upanie/sd-mux/doc/hardware/SDWire/SDWire.kicad_pcb

## KiCad design doc/hardware/SDWire/SDWire.kicad_pcb (2021-04-30)

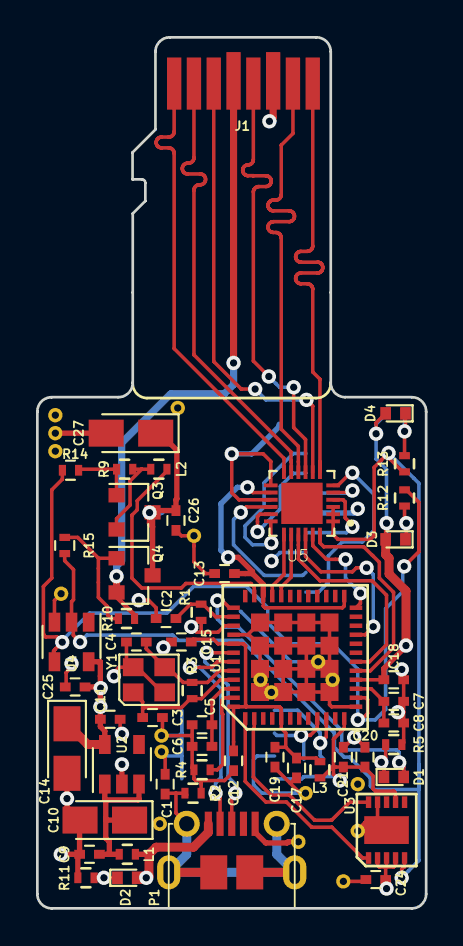
[picture p1: board SDWire.kicad_pcb from above]

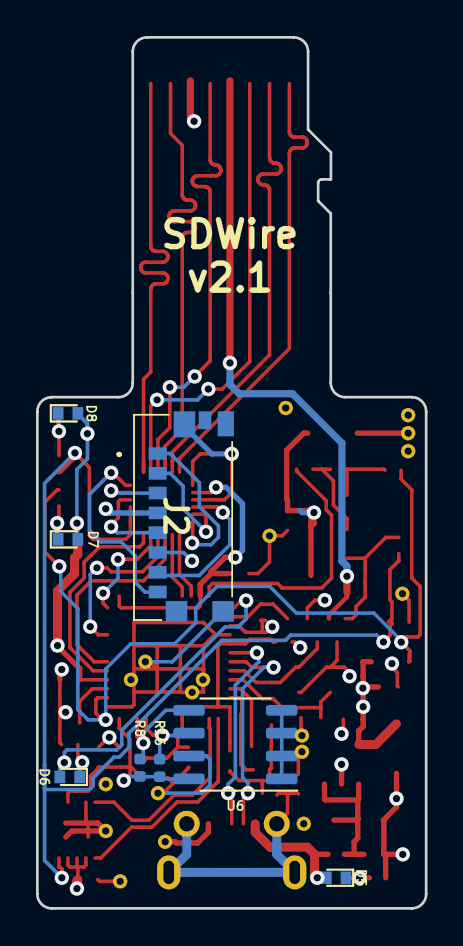
[picture p2: board SDWire.kicad_pcb from below]

Board: 4 copper layers, 21.6 x 48.4 mm, 61 parts (8 on the bottom side), 49 nets.

Parts:
C1, C2, C6, C8, C9, C11, C12, C13, C15, C17, C18, C20, C24, C25, C26: 100nF/16V; C_0402
C3, C4: 33p/50V; C_0402
C5, C7, C19, C21: 1uF/16V; C_0402
C10, C14, C27: 10uF/10V; CP_Tantalum_Case-A_EIA-3216-18_Reflow
D1, D6: OSB50402C1E; LED_0402
D2, D5: RED; LED_0402
D3, D7: BLUE; LED_0402
D4, D8: GREEN; LED_0402
J1: usd-plug; usd
J2: 47571-0001; 475710001
L1, L2, L3: BLM15PD121SN1D; R_0402
P1: USB_OTG_MICRO_USB; micro_sub_molex
Q3, Q4: MMBT4403LT1; SOT-23
R1, R2, R9, R10: 10K; R_0402
R3: 1M; R_0402
R4: 12k 1%; R_0402
R5: 330R; R_0402
R8, R16: 10K; R_0402_1005Metric
R11, R12, R13, R14, R15: 1K; R_0402
U1: USB2640-HZH-02; QFN-48-1EP_7x7mm_Pitch0.5mm
U2: SPX3819M5; SOT-23-5
U3: FT200XD; DFN-10-1EP_3x3mm_Pitch0.5mm
U4: MC74HC1G04DTT1G; SOT-23-5
U5: MAX4996L; QFN40P350X350X80-25N
U6: AT24CS02-SSHM; SO-8_3.9x4.9mm_P1.27mm
Y1: 24MHz; Crystal_SMD_2520-4pin_2.5x2.0mm

Connections:
+3V3: C11.1, C13.1, C14.1, C18.1, C20.1, C21.1, C24.1, C25.1, D3.2, D4.2, D7.2, D8.2, L3.1, R1.1, R8.1, R16.1, U1.12, U1.16, U1.25, U1.34, U1.39, U2.5, U3.2, U3.3, U3.4, U3.7, U4.5, U5.14, U6.8
/CLK_DUT: J1.5, U5.9
/CLK_TS: U1.21, U5.22
/CMD_DUT: J1.3, U5.8
/CMD_TS: U1.24, U5.23
/DAT0_DUT: J1.7, U5.10
/DAT0_TS: U1.18, U5.21
/DAT1_DUT: J1.8, U5.7
/DAT1_TS: U1.17, U5.24
/DAT2_DUT: J1.1, U5.12
/DAT2_TS: U1.33, U5.19
/DAT3_DUT: J1.2, U5.11
/DAT3_TS: U1.32, U5.20
/SOCKET_SEL: R13.2, R15.2, U3.5, U4.2, U5.1, U5.2, U5.3
/USB_B+: U1.2, U3.10
/USB_B-: U1.1, U3.1
/USB_UP+: P1.3, U1.42
/USB_UP-: P1.2, U1.43
/USD_VDD: C26.1, C27.1, J2.P4, Q3.3, Q4.3
/VDD: D2.2, D5.2, L1.2, P1.1
/VDD_DUT: J1.4, Q4.2, R10.2
/VDD_TS: L2.1, Q3.2, R9.2
/~CD_TS: R12.2, R14.2, U1.14, U4.4
/~RESET: C2.1, R1.2, U1.38
GND: C1.2, C2.2, C3.2, C4.2, C5.2, C6.2, C7.2, C8.2, C9.2, C10.2, C11.2, C12.2, C13.2, C14.2, C15.2, C17.2, C18.2, C19.2, C20.2, C21.2, C24.2, C25.2, C26.2, C27.2, J1.6, J2.G2, J2.G3, J2.P6, P1.5, R2.2, R4.2, R5.2, R11.2, U1.13, U1.40, U1.49, U2.2, U3.9, U3.11, U4.3, U5.13, U5.15, U6.1, U6.2, U6.3, U6.4, U6.7, Y1.2, Y1.4
unnamed: C1.1, P1.6, R2.1
unnamed: C3.1, R3.2, U1.45, Y1.1
unnamed: C4.1, R3.1, U1.44, Y1.3
unnamed: C5.1, C6.1, U1.46
unnamed: C7.1, C8.1, U1.15
unnamed: C9.1, C10.1, L1.1, U2.1, U2.3
unnamed: C12.1, C15.1, C17.1, C19.1, L3.2, U1.5, U1.41, U1.48
unnamed: D1.1, D6.1, R5.1
unnamed: D1.2, D6.2, U1.37
unnamed: D2.1, D5.1, R11.1
unnamed: D3.1, D7.1, R12.1
unnamed: D4.1, D8.1, R13.1
unnamed: J2.P1, U5.18
unnamed: J2.P2, U5.17
unnamed: J2.P3, U5.5
unnamed: J2.P5, U5.4
unnamed: J2.P7, U5.16
unnamed: J2.P8, U5.6
unnamed: L2.2, U1.35
unnamed: Q3.1, R9.1, R14.1
unnamed: Q4.1, R10.1, R15.1
unnamed: R4.1, U1.47
unnamed: R8.2, U1.10, U6.5
unnamed: R16.2, U1.9, U6.6
