upanie/sd-mux/(commit log)

2020-12-03 Change analog switch to max4996
    [SDWire.kicad_pcb, SDWire.sch]
2021-04-18 Update solder paste and solder mask layers
    [SDWire.kicad_pcb]
2021-04-30 Change uSD connector due to availabilty problems
    [SDWire.kicad_pcb, SDWire.sch]
