upanie/sd-mux/(notices)

Notices in the files:
doc/hardware/SDWire/SDWire.sch:
Copyright (c) 2016 Samsung Electronics Co., Ltd All Rights Reserved
